adunn-kal/WaterSense/README.md

# WaterSense
 Main firmware for the Water Sense project.
 
 See https://adunn-kal.github.io/WaterSense/ for more details.
