adunn-kal/WaterSense/Eagle Files/RTK System/rtkSchematic.brd

## EAGLE design Eagle Files/RTK System/rtkSchematic.brd (2023-06-13)

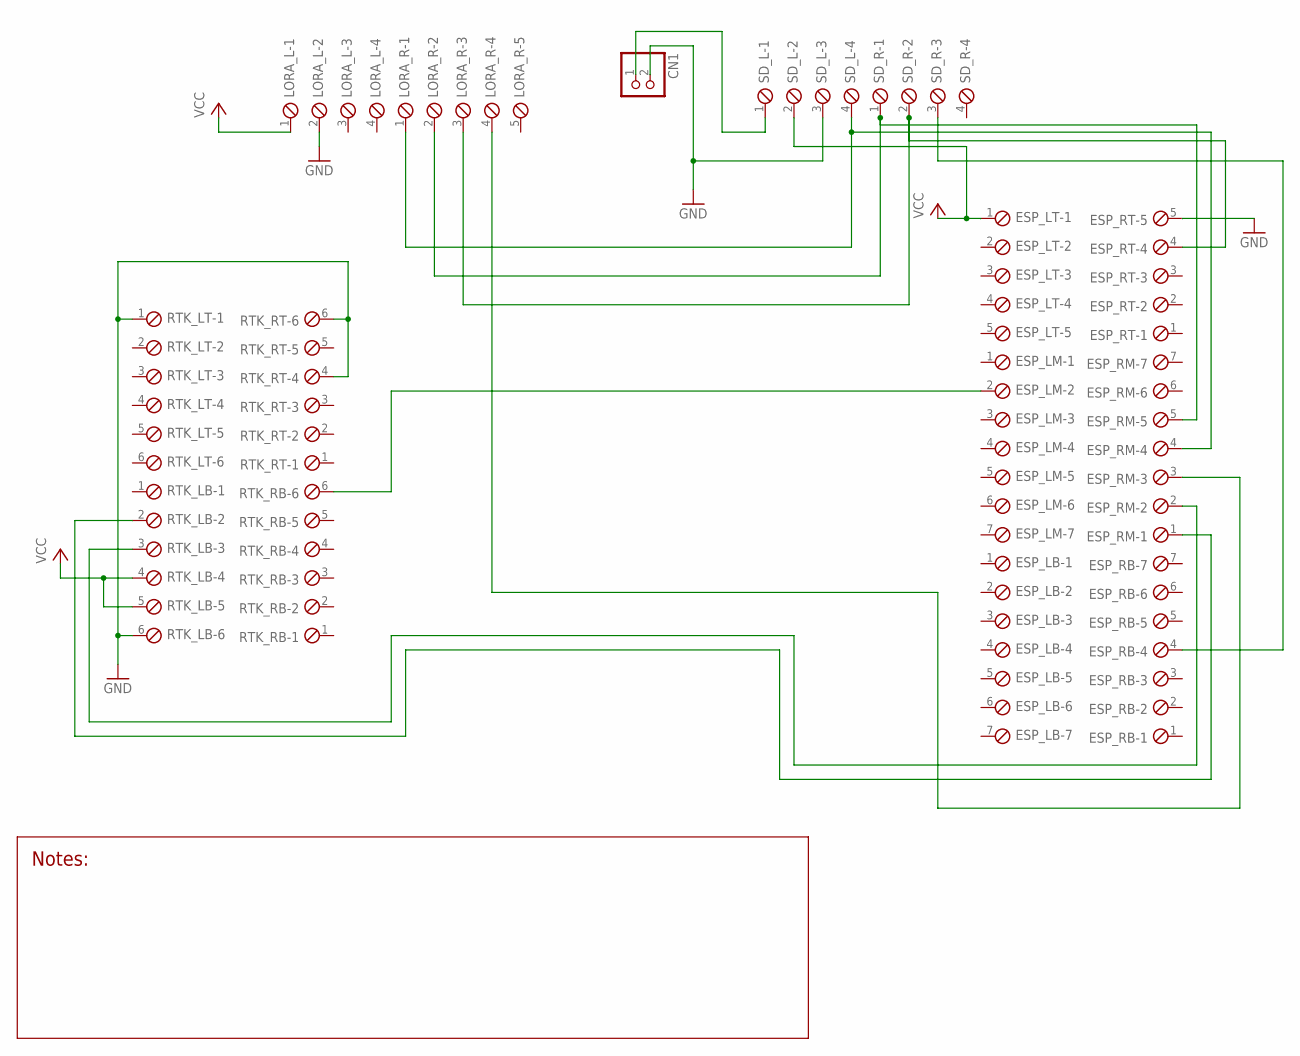
[picture p1: schematic rtkSchematic.sch]

Parts:
CN1: JST_2PIN-SMT-RA; JST-PH-2-SMT-RA
ESP_LB: SCREWTERM_7P_254; 7POL254
ESP_LM: SCREWTERM_7P_254; 7POL254
ESP_LT: SCREWTERM_5P_254; 5POL254
ESP_RB: SCREWTERM_7P_254; 7POL254
ESP_RM: SCREWTERM_7P_254; 7POL254
ESP_RT: SCREWTERM_5P_254; 5POL254
LORA_L: SCREWTERM_4P_254; 4POL254
LORA_R: SCREWTERM_5P_254; 5POL254
RTK_LB: SCREWTERM_6P_254; 6POL254
RTK_LT: SCREWTERM_6P_254; 6POL254
RTK_RB: SCREWTERM_6P_254; 6POL254
RTK_RT: SCREWTERM_6P_254; 6POL254
SD_L: SCREWTERM_4P_254; 4POL254
SD_R: SCREWTERM_4P_254; 4POL254

Connections:
GND: CN1.2 (1), ESP_RT.5, LORA_L.2, RTK_LB.6, RTK_LT.1, RTK_RT.4, RTK_RT.6, SD_L.3
unnamed: ESP_LM.2, RTK_RB.6
unnamed: CN1.1 (2), SD_L.1
unnamed: ESP_RM.4, LORA_R.1, SD_L.4
unnamed: ESP_RM.5, LORA_R.2, SD_R.1
unnamed: ESP_RT.4, LORA_R.3, SD_R.2
unnamed: ESP_RB.4, SD_R.3
unnamed: ESP_RM.2, RTK_LB.3
unnamed: ESP_RM.1, RTK_LB.2
unnamed: ESP_RM.3, LORA_R.4
VCC: ESP_LT.1, LORA_L.1, RTK_LB.4, RTK_LB.5, SD_L.2

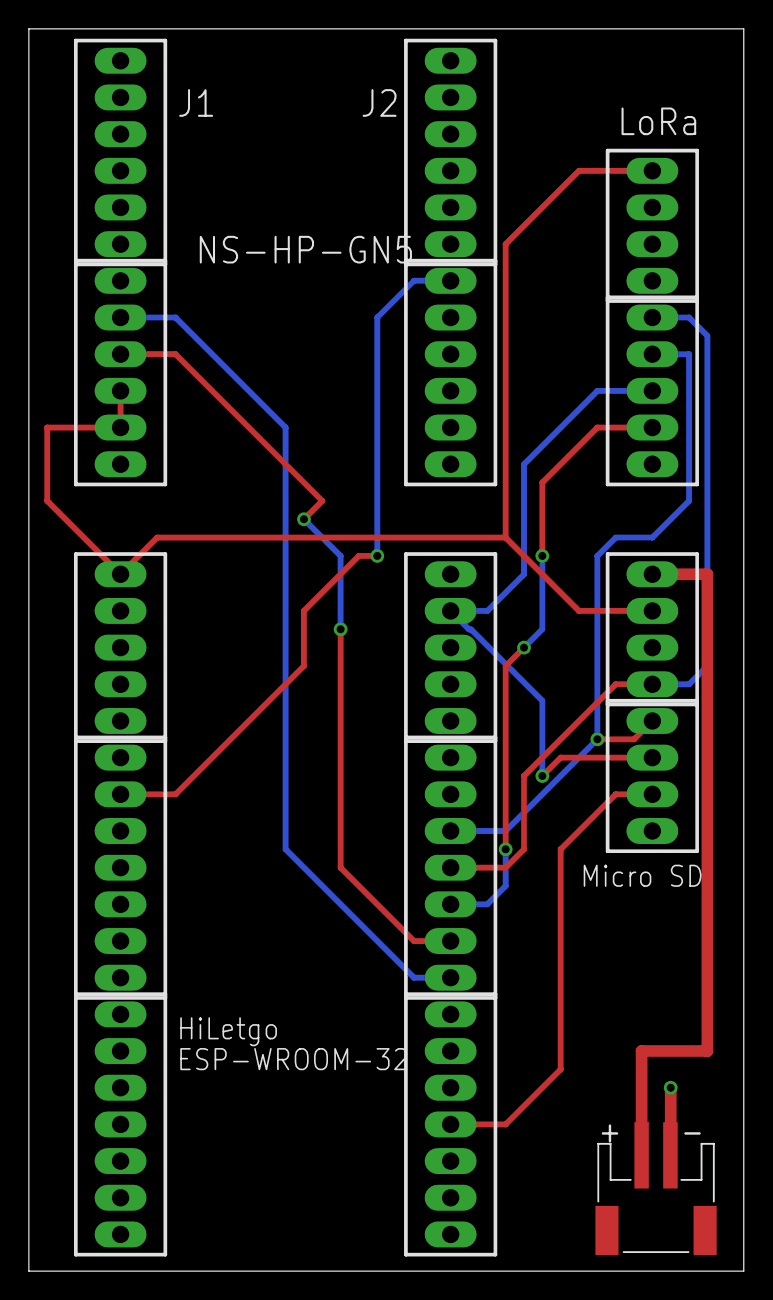
[picture p2: board rtkSchematic.brd from above]

Board: 2 copper layers, 49.5 x 86.0 mm, 15 parts (0 on the bottom side), 11 nets.
