adunn-kal/WaterSense/Eagle Files/Main Gauge/TideGauge.brd

## EAGLE design Eagle Files/Main Gauge/TideGauge.brd (2023-06-13)

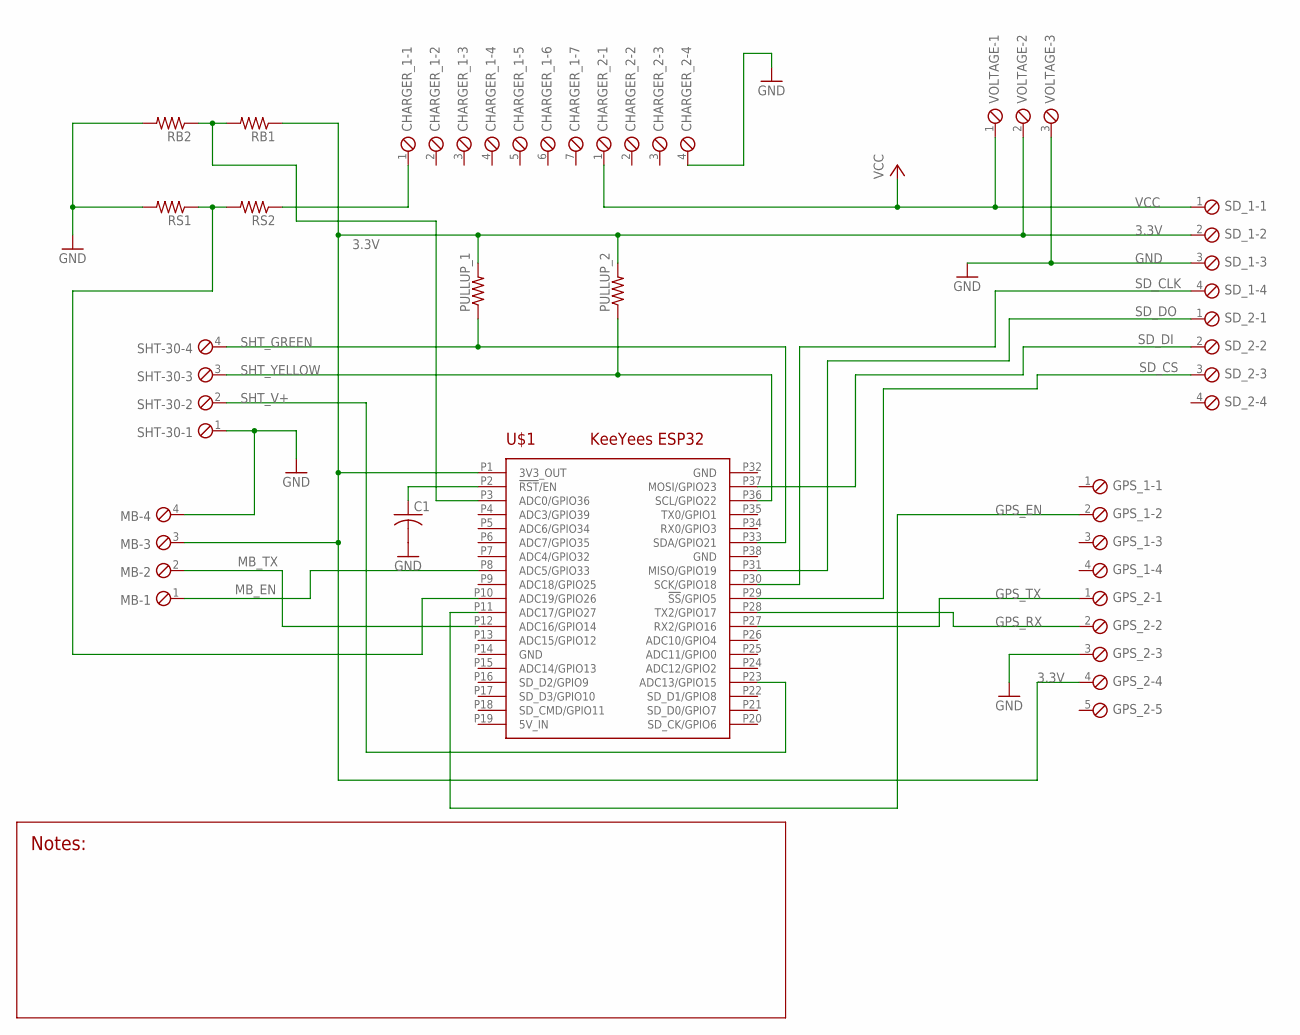
[picture p3: schematic TideGauge.sch]

Parts:
C1: C-USC0805; C0805
CHARGER_1: SCREWTERM_7P_254; 7POL254
CHARGER_2: SCREWTERM_4P_254; 4POL254
GPS_1: SCREWTERM_4P_254; 4POL254
GPS_2: SCREWTERM_5P_254; 5POL254
MB: SCREWTERM_4P_254; 4POL254
PULLUP_1, PULLUP_2: R-US_M0805; M0805
RB1, RB2: R-US_R0805; R0805
RS1, RS2: R-US_R0805; R0805
SD_1, SD_2: SCREWTERM_4P_254; 4POL254
SHT-30: SCREWTERM_4P_254; 4POL254
U$1: KEEYEES_ESP32
VOLTAGE: SCREWTERM_3P_254; 3POL254

Connections:
3.3V: GPS_2.4, MB.3, PULLUP_1.2, PULLUP_2.2, RB1.1, SD_1.2, U$1.P1 (3V3_OUT), VOLTAGE.2
5V_IN: U$1.P19 (5V_IN)
GND: C1.2, CHARGER_2.4, GPS_2.3, MB.4, RB2.2, RS1.2, SD_1.3, SHT-30.1, U$1.P14 (GND), U$1.P32 (GND), U$1.P38 (GND), VOLTAGE.3
GPS_EN: GPS_1.2, U$1.P11 (ADC17/GPIO27)
GPS_RX: GPS_2.2, U$1.P28 (TX2/GPIO17)
GPS_TX: GPS_2.1, U$1.P27 (RX2/GPIO16)
MB_EN: MB.1, U$1.P8 (ADC5/GPIO33)
MB_TX: MB.2, U$1.P12 (ADC16/GPIO14)
unnamed: C1.1, U$1.P2 (!RST!/EN)
unnamed: CHARGER_1.1, RS2.1
unnamed: RS1.1, RS2.2, U$1.P10 (ADC19/GPIO26)
unnamed: RB1.2, RB2.1, U$1.P3 (ADC0/GPIO36)
SD_CLK: SD_1.4, U$1.P30 (SCK/GPIO18)
SD_CS: SD_2.3, U$1.P29 (!SS!/GPIO5)
SD_DI: SD_2.2, U$1.P37 (MOSI/GPIO23)
SD_DO: SD_2.1, U$1.P31 (MISO/GPIO19)
SHT_GREEN: PULLUP_1.1, SHT-30.4, U$1.P33 (SDA/GPIO21)
SHT_V+: SHT-30.2, U$1.P23 (ADC13/GPIO15)
SHT_YELLOW: PULLUP_2.1, SHT-30.3, U$1.P36 (SCL/GPIO22)
VCC: CHARGER_2.1, SD_1.1, VOLTAGE.1

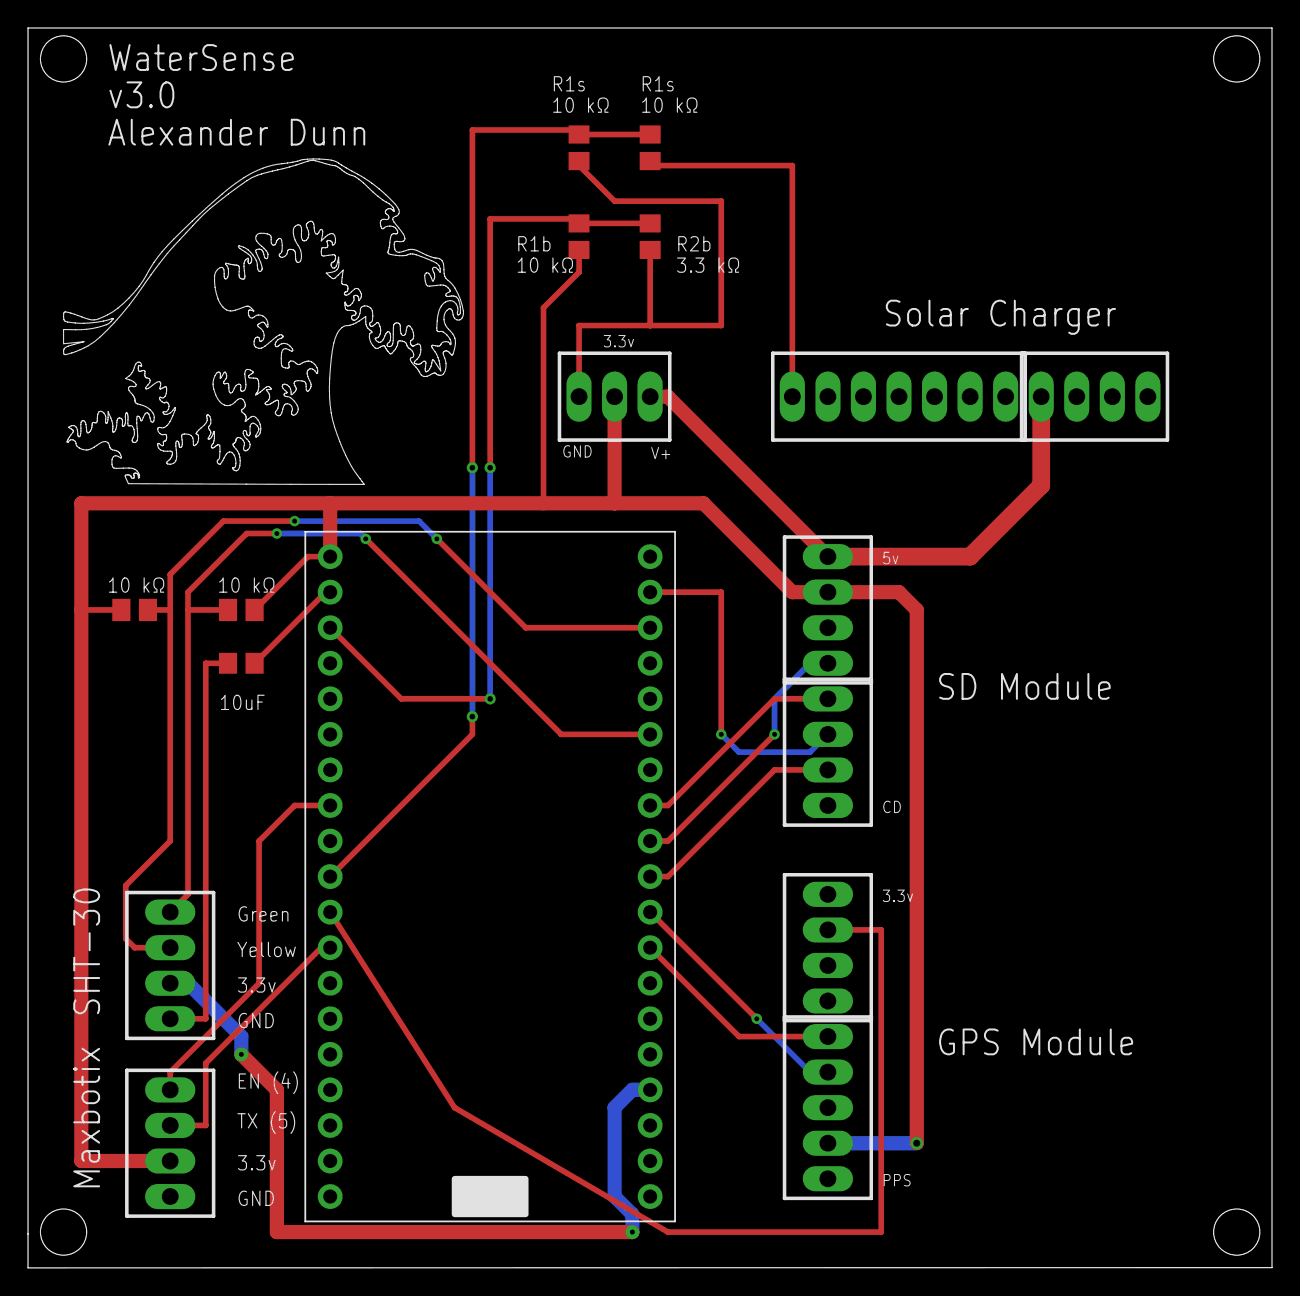
[picture p4: board TideGauge.brd from above]

Board: 2 copper layers, 88.9 x 88.6 mm, 17 parts (0 on the bottom side), 19 nets.
