adunn-kal/WaterSense/waterSense/src/main.cpp

/**
 * @file main.cpp
 * @author Alexander Dunn
 * @brief The main waterSense software file
 * @version 0.1
 * @date 2022-12-18
 * 
 * @copyright Copyright (c) 2022
 * 
 */

#include <Arduino.h>
#include "setup.h"
#include "sharedData.h"
#include "waterSenseTasks/taskMeasure/taskMeasure.h"
#include "waterSenseTasks/taskSD/taskSD.h"
#include "waterSenseTasks/taskClock2/taskClock2.h"
#include "waterSenseTasks/taskSleep/taskSleep.h"
#include "waterSenseTasks/taskVoltage/taskVoltage.h"
#include "waterSenseTasks/taskWatch/taskWatch.h"


//-----------------------------------------------------------------------------------------------------||
//---------- Shares & Queues --------------------------------------------------------------------------||

// Non-volatile Variables
RTC_DATA_ATTR uint32_t wakeCounter = 0; ///< A counter representing the number of wake cycles
RTC_DATA_ATTR uint32_t lastKnownUnix = 0;
RTC_DATA_ATTR uint32_t unixRtcStart = 0;
RTC_DATA_ATTR bool internal = false;

// Watchdog Checks
Share<bool> clockCheck("Clock Working");
Share<bool> sleepCheck("Sleep Working");
Share<bool> measureCheck("Measure Working");
Share<bool> voltageCheck("Voltage Working");
Share<bool> sdCheck("SD Working");

// Flags
Share<bool> dataReady("Data Ready"); ///< A shared variable to indicate availability of new ultrasonic measurements
Share<bool> sleepFlag("Sleep Flag"); ///< A shared variable to trigger sleep operations
Share<bool> clockSleepReady("Clock Sleep Ready"); ///< A shared variable to indicate the clock is ready to sleep
Share<bool> sonarSleepReady("Sonar Sleep Ready"); ///< A shared variable to indicate the sonar sensor is ready to sleep
Share<bool> tempSleepReady("Temp Sleep Ready"); ///< A shared variable to indicate the temp sensor is ready to sleep
Share<bool> sdSleepReady("SD Sleep Ready"); ///< A shared variable to indicate the SD card is ready to sleep

// Shares from GPS Clock
Share<float> latitude("Latitude"); ///< The current latitude [Decimal degrees]
Share<float> longitude("Longitude"); ///< The current longitude [Decimal degrees]
Share<float> altitude("Altitude"); ///< The current altitude [meters above MSL]
Share<uint8_t> fixType("Fix Type"); ///< The current fix type
Share<String> unixTime("Unix Time"); ///< The current Unix timestamp relative to GMT
Share<String> displayTime("Display Time"); ///< The current time of day relative to GMT
Share<bool> wakeReady("Wake Ready"); ///< Indicates whether or not the device is ready to wake
Share<uint64_t> sleepTime("Sleep Time"); ///< The number of microseconds to sleep

// Shares from sensors
Share<int16_t> distance("Distance"); ///< The distance measured by the ultrasonic sensor in millimeters
Share<float> temperature("Temperature"); ///< The temperature in Fahrenheit
Share<float> humidity("Humidity"); ///< The relative humidity in %

// Duty Cycle
Share<float> solar("Solar Voltage"); ///< The solar panel voltage
Share<float> battery("Battery Voltage"); ///< The input voltage to the MCU
Share<uint16_t> READ_TIME("Read Time"); ///< The current read time in seconds
Share<uint16_t> MINUTE_ALLIGN("Minute Allign"); ///< The current minute allignment

//-----------------------------------------------------------------------------------------------------||
//-----------------------------------------------------------------------------------------------------||










//-----------------------------------------------------------------------------------------------------||
//---------- Program ----------------------------------------------------------------------------------||

void setup()
{
  // Setup
  // setCpuFrequencyMhz(80);
  Serial.begin(115200);
  while (!Serial) {}
  Serial.println("\n\n\n\n");

  wakeReady.put(false);
  READ_TIME.put(HI_READ);
  MINUTE_ALLIGN.put(HI_ALLIGN);

  // Setup tasks
  xTaskCreate(taskMeasure, "Measurement Task", 8192, NULL, 3, NULL);
  xTaskCreate(taskSD, "SD Task", 8192, NULL, 7, NULL);
  xTaskCreate(taskClock2, "Clock Task", 8192, NULL, 5, NULL);
  xTaskCreate(taskSleep, "Sleep Task", 8192, NULL, 1, NULL);
  xTaskCreate(taskVoltage, "Voltage Task", 8192, NULL, 1, NULL);
  xTaskCreate(taskWatch, "Watchdog Task", 8192, NULL, 10, NULL);
}

void loop()
{
  // Loop
}

//-----------------------------------------------------------------------------------------------------||
//-----------------------------------------------------------------------------------------------------||
