adunn-kal/WaterSense/(commit log)

2023-02-02 Added solar voltage task
2023-02-02 Added solar voltage tracking and blinking LED
2023-02-02 Removed blinking functionality (didn't work)
    [sdData.cpp, sdData.h]
2023-02-03 Added LED support within classes
2023-02-04 Fixed lat long format
    [gpsClock.cpp]
2023-02-04 Added battery and voltage data storage
2023-02-04 Added battery and solar voltage functionality. Variable duty cycle based on battery voltage
2023-02-15 Fixed low power mode (previously used unit8_t -> overflow issues)
    [gpsClock.cpp, gpsClock.h, setup.h, taskSleep.cpp]
2023-03-08 Added functionality to fix SD file naming
    [sdData.cpp, taskSleep.cpp]
2023-04-09 Possible fix for slow clock SD card loss
    [main.cpp, sdData.cpp, setup.h]
2023-06-13 Added Eagle files
    [TideGauge.brd, TideGauge.sch, rtkSchematic.brd, rtkSchematic.sch]
